iwax2/74xx_tester_i2c/(commit log)

2017-03-23 DFFのバグ修正
2017-03-23 基板写真を追加
2019-04-26 TODO追加
2019-04-26 謎の再起動バグを修正した
2019-05-31 JK-FF Not foundのバグ修正
